zozimoTech/ESP8266_RTOS_SDK/workspace/systemMonitorLab/hardware/Documentos/ESP8266/PinOut.png

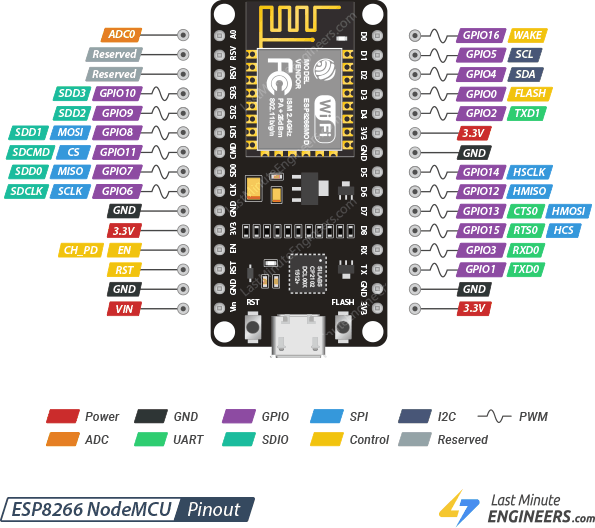
workspace/systemMonitorLab/hardware/Documentos/ESP8266/PinOut.png
