zozimoTech/ESP8266_RTOS_SDK/workspace/systemMonitorLab/hardware/NodoAmbienteSMN/NodoV2/pcb_build_resources/listaComponentesCompra.xlsx

Sheet: listaComponentesCompra
Qty 1 nodo | Qty Total 6 nodos | Value | Proveedor link | Precio unidad | Precio total | Datasheet
6 | 36 | MACHO .100" P/CI 4 VIAS 90* | https://www.sycelectronica.com.ar/articulo.php?codigo=WF4R | 108 | 3888
 | 0 | TERMINAL CRIMPEABLE EN ROLLO | https://www.sycelectronica.com.ar/articulo.php?codigo=HUT | 48 | 0
6 | 36 | HEMBRA A CABLE .1" 4 V | https://www.sycelectronica.com.ar/articulo.php?codigo=HU4 | 60 | 2160
1 | 6 | WF2R MACHO .100" P/CI 2 VIAS 90* | https://www.sycelectronica.com.ar/articulo.php?codigo=WF2R | 66 | 396
1 | 6 | ConectorDCRoscaHembra | https://www.electrocomponentes.com/tienda/componentes-electronicos/conectores/jackdc21rosca?q=JACKDC2.1ROSCA | 2261 | 13566
3 | 18 | BC847B NPN 100MA 50V SMD (SOT-23) | https://www.sycelectronica.com.ar/articulo.php?codigo=BC847B | 60 | 1080
2 | 12 | RESISTOR SMD 1206 100PCS 5K6 | https://www.sycelectronica.com.ar/articulo.php?codigo=CR1206-5K6 | 1104 | 13248
3 | 18 | CR1206-1K RESISTOR SMD 1206 100PCS 1K | https://www.sycelectronica.com.ar/articulo.php?codigo=CR1206-1K | 1104 | 19872
2 | 12 | CR1206-100 RESISTOR SMD 1206 100PCS 100E | https://www.sycelectronica.com.ar/articulo.php?codigo=CR1206-100 | 1104 | 13248
3 | 18 | CR1206-47 RESISTOR SMD 1206 100PCS 47E (En lugar de 39 Ohm) | https://www.sycelectronica.com.ar/articulo.php?codigo=CR1206-47 | 1104 | 19872
3 | 18 | FCG10C CABLE PLANO 10 VIAS COLOR (18 metros) | https://www.sycelectronica.com.ar/articulo.php?codigo=FCG10C |  | 0
 | 0 |  |  |  | 0
 | 0 |  |  |  | 0
 | 0 |  |  |  | 0
 | 0 |  |  |  | 0
 | 0 |  |  |  | 0
 | 0 |  |  |  | 0
 | 0 |  |  |  | 0
 | 0 |  |  |  | 0

Sheet: BOM
Reference | Qty | Value | Footprint | Proveedor link | Precio unidad | Precio total | Datasheet
D1 | 1 | LED_YELLOW | LED_THT:LED_D3.0mm |  |  | 0 | ~
D2 | 1 | LED_Dual_AKA | LED_THT:LED_D3.0mm-3 |  |  | 0 | ~
J1 | 1 | Molex_MainBoard_DHT22 | Connector_PinHeader_2.54mm:PinHeader_1x04_P2.54mm_Horizontal | https://www.sycelectronica.com.ar/articulo.php?codigo=WF4R | 108 | 108 | ~
J2 | 1 | Molex_MainBoard_BMP280 | Connector_PinHeader_2.54mm:PinHeader_1x04_P2.54mm_Horizontal | https://www.sycelectronica.com.ar/articulo.php?codigo=WF4R | 108 | 108 | ~
J3 | 1 | Molex_MainBoard_Led_Status | Connector_PinHeader_2.54mm:PinHeader_1x04_P2.54mm_Horizontal | https://www.sycelectronica.com.ar/articulo.php?codigo=WF4R | 108 | 108 | ~
J4 | 1 | DC 5V | Connector_PinHeader_2.54mm:PinHeader_1x02_P2.54mm_Horizontal |  |  | 0 | ~
J5 | 1 | Molex_Sensor_BMP280 | Connector_PinHeader_2.54mm:PinHeader_1x04_P2.54mm_Horizontal | https://www.sycelectronica.com.ar/articulo.php?codigo=WF4R | 108 | 108 | ~
J6 | 1 | Molex_Sensor_DHT22 | Connector_PinHeader_2.54mm:PinHeader_1x04_P2.54mm_Horizontal | https://www.sycelectronica.com.ar/articulo.php?codigo=WF4R | 108 | 108 | ~
J7 | 1 | Molex_Led_Status | Connector_PinHeader_2.54mm:PinHeader_1x04_P2.54mm_Horizontal | https://www.sycelectronica.com.ar/articulo.php?codigo=WF4R | 108 | 108 | ~
Q1-Q2-Q3 | 3 | NPN | Package_TO_SOT_SMD:SOT-23 |  |  | 0 | https://ngspice.sourceforge.io/docs/ngspice-html-manual/manual.xhtml#cha_BJTs
R1 | 1 | 5K6 | Resistor_SMD:R_1206_3216Metric |  |  | 0 | ~
R2-R4-R7 | 3 | 1k | Resistor_SMD:R_1206_3216Metric |  |  | 0 | ~
R3 | 1 | 100 | Resistor_SMD:R_1206_3216Metric |  |  | 0 | ~
R5-R6 | 2 | 39 | Resistor_SMD:R_1206_3216Metric |  |  | 0 | ~
U1 | 1 | NodeMcuEsp8266 | Module_commercial:ESP8266_v3 |  |  | 0
U2 | 1 | Bmp280Module | Sensors_commercial:BMP280_Module |  |  | 0
U3 | 1 | DHT22 | Sensor:Aosong_DHT11_5.5x12.0_P2.54mm |  |  | 0
