zozimoTech/ESP8266_RTOS_SDK/workspace/systemMonitorLab/hardware/NodoAmbienteSMN/NodoV2/PcbSistemaAmbienteLab_shield_base_2.step

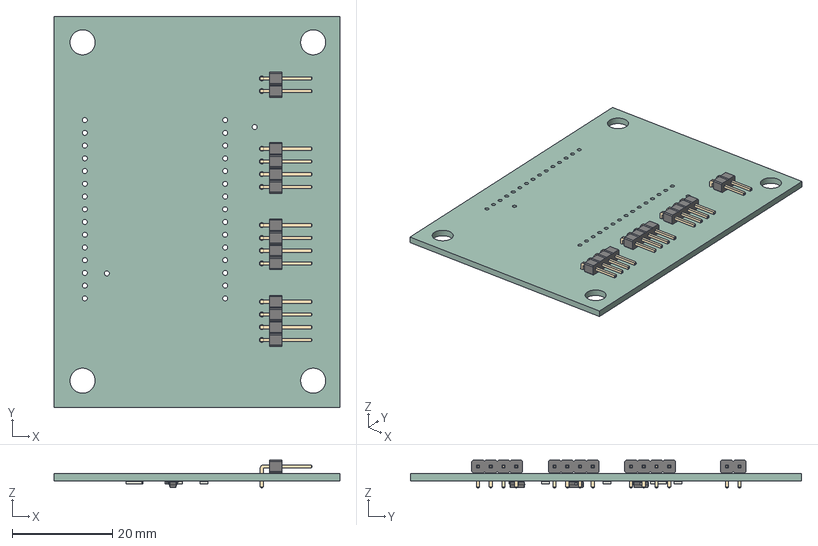
[picture p2: CAD file, 2026-03-22]
workspace/systemMonitorLab/hardware/NodoAmbienteSMN/NodoV2/PcbSistemaAmbienteLab_shield_base_2.step
57.0 x 78.0 x 5.54 mm
PinHeader_1x04_P2.54mm_Horizontal x 3
PinHeader_1x02_P2.54mm_Horizontal
SOT-23 x 3
R_1206_3216Metric x 7
PcbSistemaAmbienteLab_shield_base_2_PCB
