zozimoTech/ESP8266_RTOS_SDK/workspace/systemMonitorLab/hardware/NodoAmbienteSMN/NodoV2/negativos/PcbSistemaAmbienteLab_shield_Leds-B_Cu.pdf

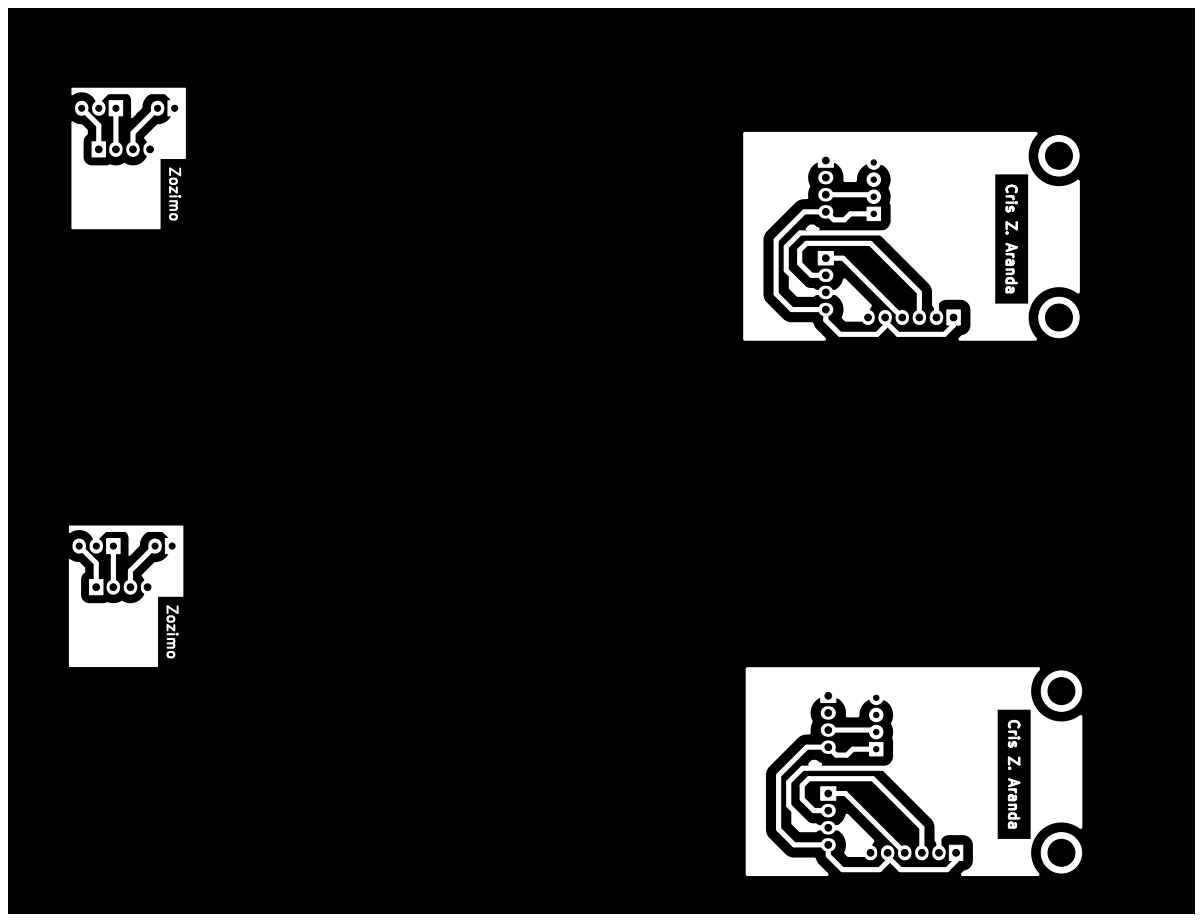
[picture p4: page 1]

Zozimo Cris Z. Aranda Cris Z. Aranda Zozimo
