zozimoTech/ESP8266_RTOS_SDK/workspace/systemMonitorLab/hardware/NodoAmbienteSMN/NodoV2/negativos/PcbSistemaAmbienteLab_shield_Leds-F_Mask.pdf

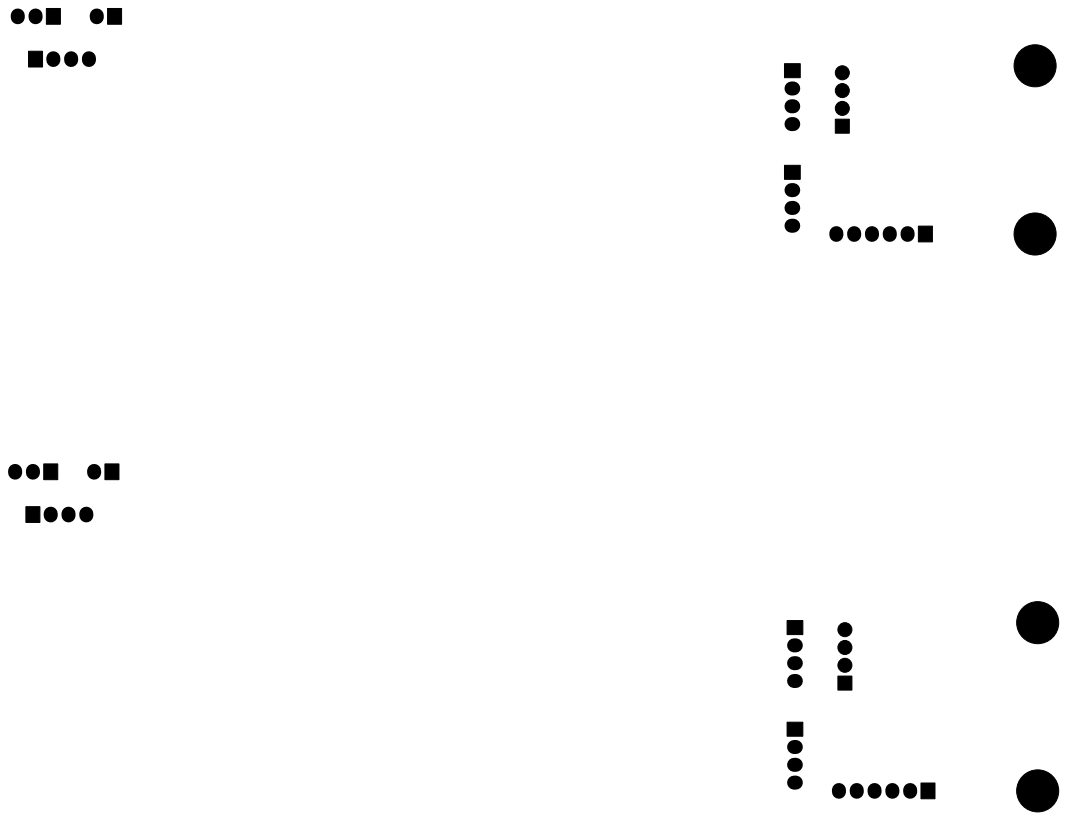
[picture p5: page 1]
