zozimoTech/ESP8266_RTOS_SDK/workspace/systemMonitorLab/hardware/NodoAmbienteSMN/NodoV2/negativos/PcbSistemaAmbienteLab_shield_base_2-B_Cu.pdf

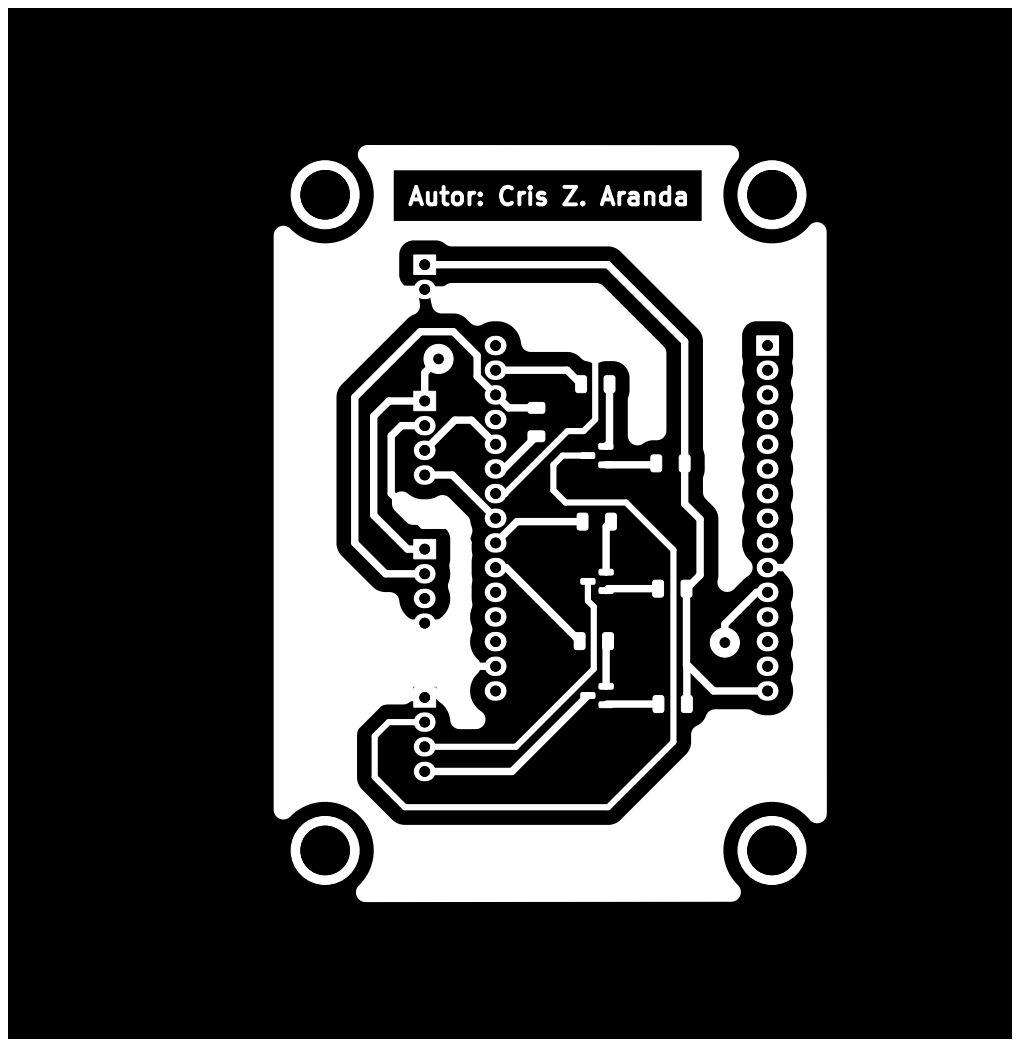
[picture p6: page 1]
