zozimoTech/ESP8266_RTOS_SDK/workspace/systemMonitorLab/hardware/NodoAmbienteSMN/NodoV2/pcb_build_resources/PCB_shield_main_board.pdf

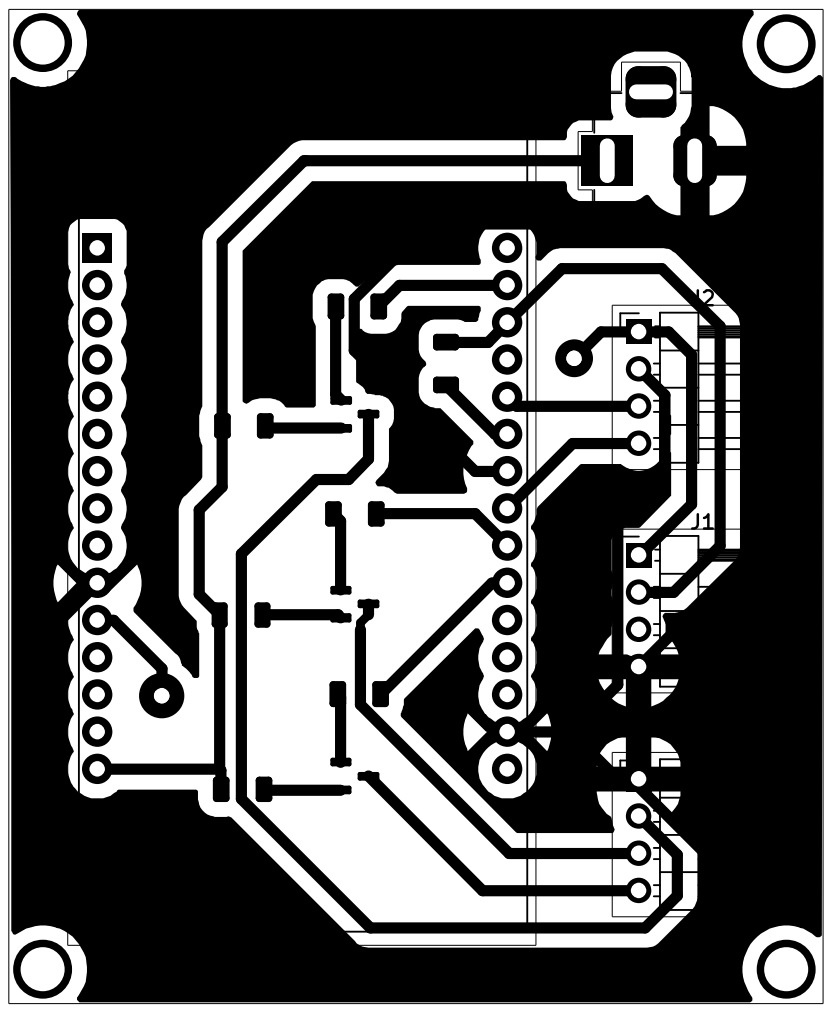
[picture p7: page 1]
