zozimoTech/ESP8266_RTOS_SDK/workspace/systemMonitorLab/hardware/NodoAmbienteSMN/NodoV2/pcb_build_resources/PCB_shield_main_board_mirror.pdf

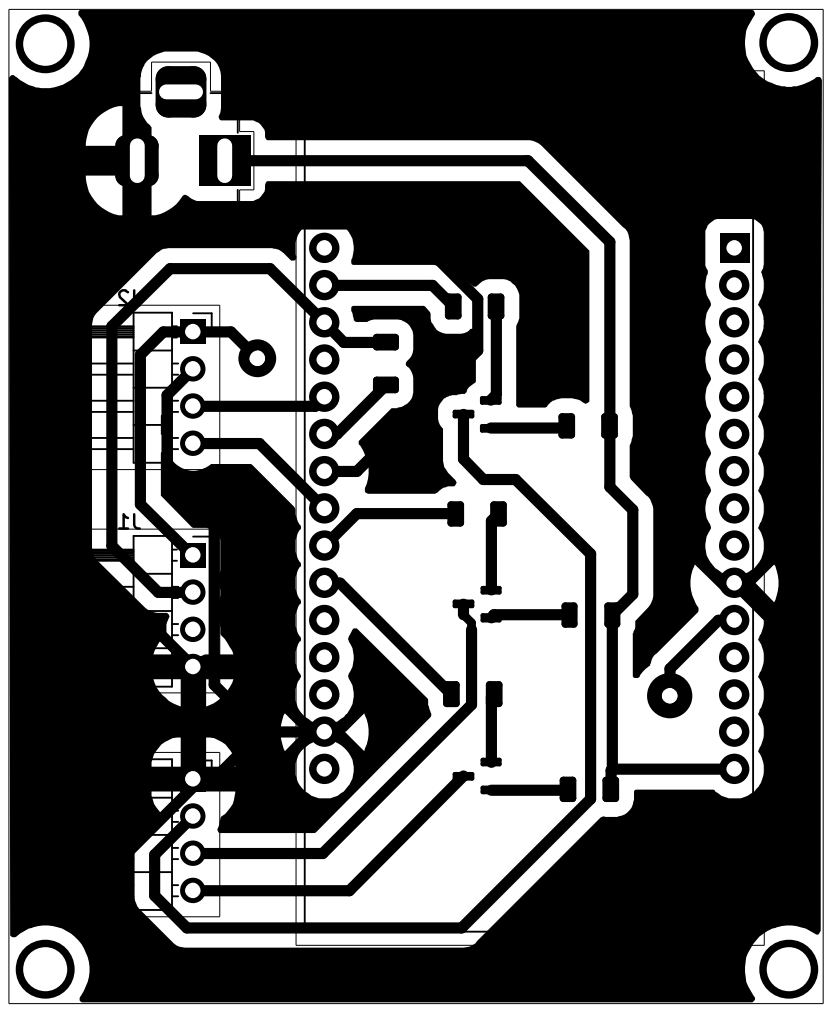
[picture p8: page 1]
