zozimoTech/ESP8266_RTOS_SDK/workspace/systemMonitorLab/hardware/NodoAmbienteSMN/recursos/simulaciones/control_LED_3_3_to_5.asc

D1: LED
Q1: npn
R1: res; 39
R2: res; 1k
V1: voltage; 5v
V2: voltage; PULSE(0 3.3 0 0 0 250u 1m 10)
Named nets: 0
.tran 0 100ms 0 500u
