zozimoTech/ESP8266_RTOS_SDK/workspace/systemMonitorLab/hardware/NodoAmbienteSMN/recursos/simulaciones/convertidor3_3_to_5.asc

Q1: npn
R1: res; 10k
R2: res; 4.7k
R3: res; 10k
R4: res; 1Meg
V1: voltage; 3.3
V2: voltage; 5
V3: voltage; PULSE(0 3.3 0 0 0 500u 1m 100)
Named nets: 0, vpwm, pwm5v
.tran 0 50m 0 1ms
