zozimoTech/ESP8266_RTOS_SDK/workspace/systemMonitorLab/hardware/NodoAmbienteSMN/NodoV2/PcbSistemaAmbienteLab.kicad_pcb

## KiCad design workspace/systemMonitorLab/hardware/NodoAmbienteSMN/NodoV2/PcbSistemaAmbienteLab.kicad_pcb (2025-08-23)

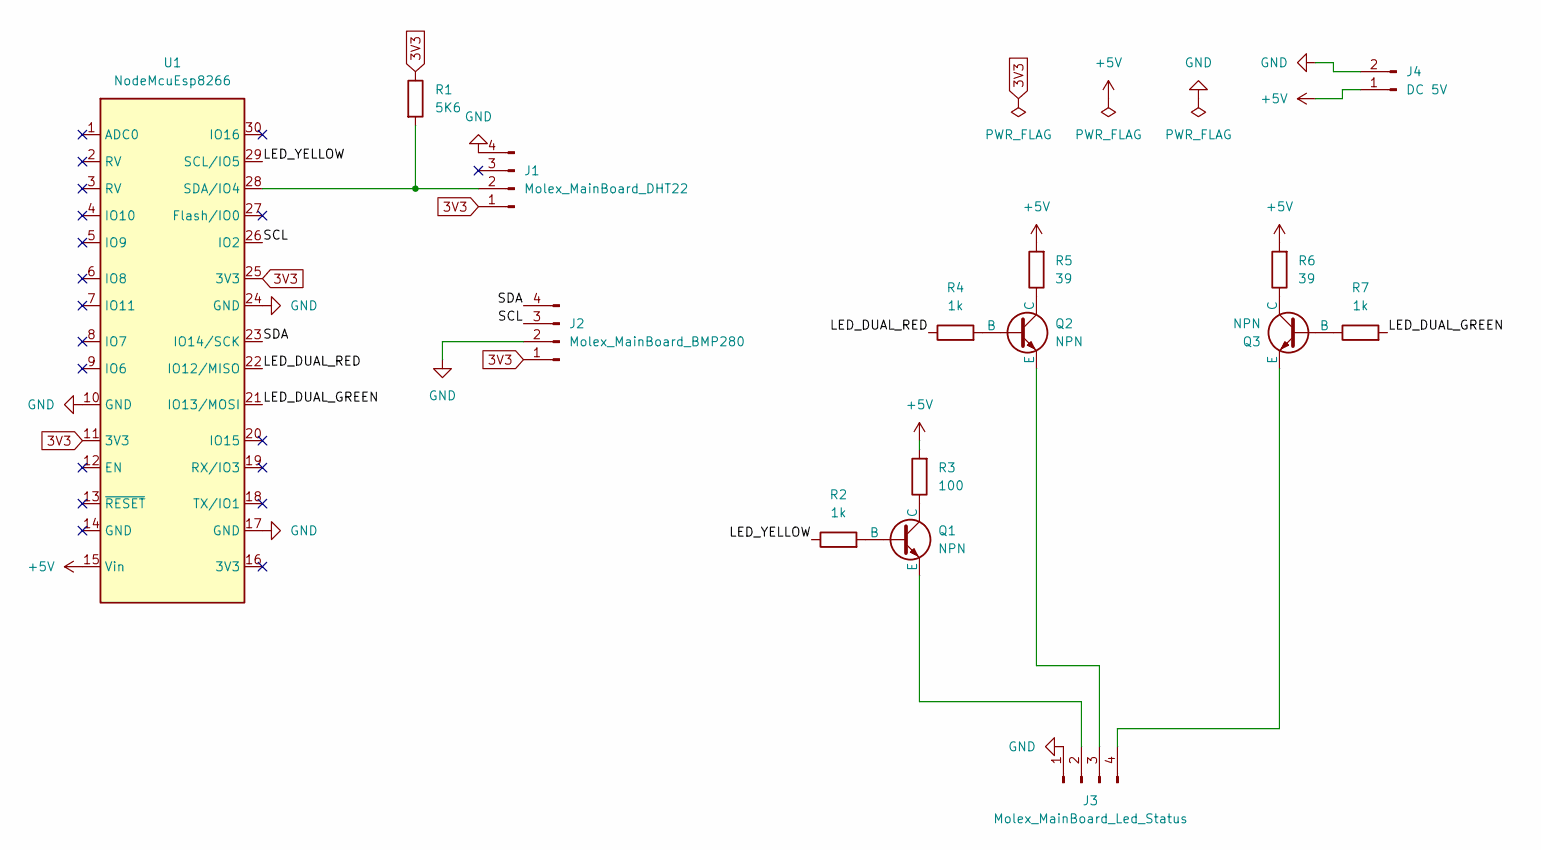
[picture p9: schematic shield_base.kicad_sch, shield_base_nodo_lab_smn]

Parts:
J1: Molex_MainBoard_DHT22; PinHeader_1x04_P2.54mm_Horizontal
J2: Molex_MainBoard_BMP280; PinHeader_1x04_P2.54mm_Horizontal
J3: Molex_MainBoard_Led_Status; PinHeader_1x04_P2.54mm_Horizontal
J4: DC 5V; PinHeader_1x02_P2.54mm_Horizontal
Q1, Q2, Q3: NPN; SOT-23
R1: 5K6; R_1206_3216Metric
R2, R4, R7: 1k; R_1206_3216Metric
R3: 100; R_1206_3216Metric
R5, R6: 39; R_1206_3216Metric
U1: NodeMcuEsp8266; ESP8266_v3

Connections:
3V3: J1.1, J2.1, R1.1, U1.11 (3V3), U1.25 (3V3); also elsewhere on the board
+5V: J4.1, R3.2, R5.2, R6.2, U1.15 (Vin)
/shield_base/LED_DUAL_GREEN: R7.2, U1.21 (IO13/MOSI)
/shield_base/LED_DUAL_RED: R4.1, U1.22 (IO12/MISO)
/shield_base/LED_YELLOW: R2.1, U1.29 (SCL/IO5)
/shield_base/SCL: J2.3, U1.26 (IO2)
/shield_base/SDA: J2.4, U1.23 (IO14/SCK)
GND: J1.4, J2.2, J3.1, J4.2, U1.10 (GND), U1.17 (GND), U1.24 (GND); also elsewhere on the board
unnamed: J1.2, R1.2, U1.28 (SDA/IO4)
unnamed: J3.2, Q1.3 (E)
unnamed: J3.3, Q2.3 (E)
unnamed: J3.4, Q3.3 (E)
unnamed: Q1.2 (B), R2.2
unnamed: Q1.1 (C), R3.1
unnamed: Q2.2 (B), R4.2
unnamed: Q2.1 (C), R5.1
unnamed: Q3.2 (B), R7.1
unnamed: Q3.1 (C), R6.1

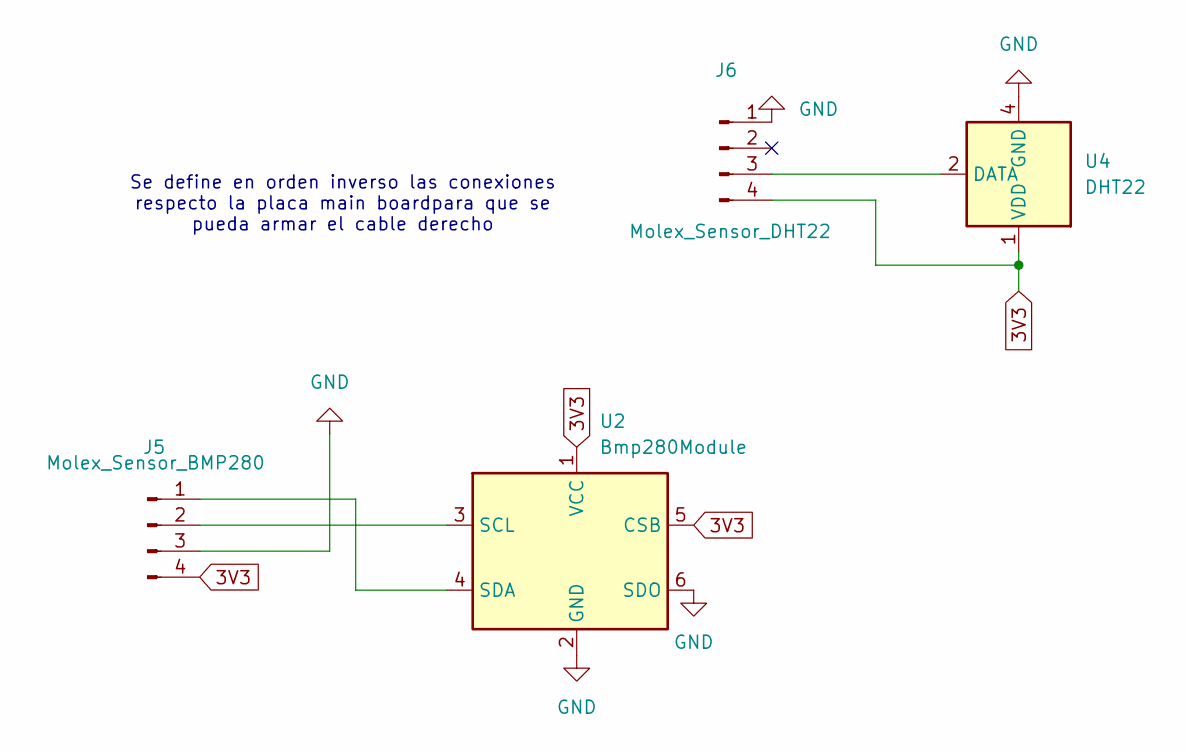
[picture p10: schematic shield_sensor.kicad_sch, shield_sensors_nodo]

Parts:
J5: Molex_Sensor_BMP280; PinHeader_1x04_P2.54mm_Horizontal
J6: Molex_Sensor_DHT22; PinHeader_1x04_P2.54mm_Horizontal
U2: Bmp280Module; BMP280_Module
U4: DHT22; Aosong_DHT11_5.5x12.0_P2.54mm

Connections:
3V3: J5.4, J6.4, U2.1 (VCC), U2.5 (CSB), U4.1 (VDD); also elsewhere on the board
GND: J5.3, J6.1, U2.2 (GND), U2.6 (SDO), U4.4 (GND); also elsewhere on the board
unnamed: J5.1, U2.4 (SDA)
unnamed: J5.2, U2.3 (SCL)
unnamed: J6.3, U4.2 (DATA)

Notes on the sheet:
Se define en orden inverso las conexiones respecto la placa main boardpara que se pueda armar el cable derecho

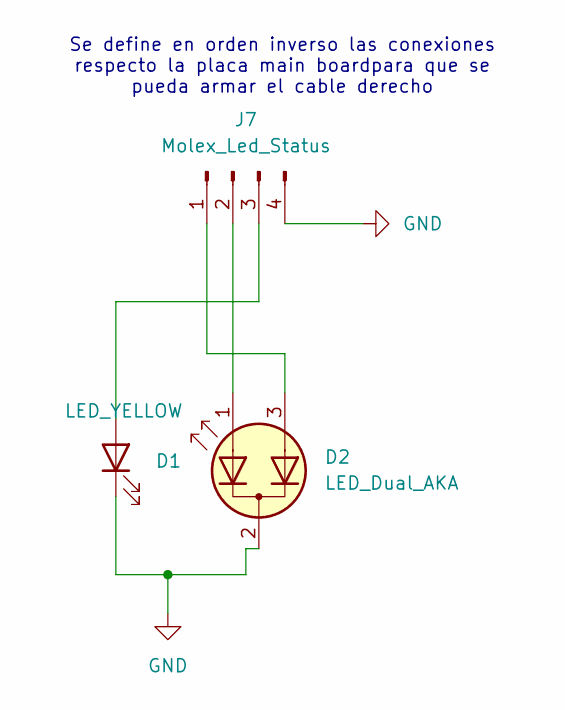
[picture p11: schematic shield_leds_status.kicad_sch, shield_leds_status_nodo]

Parts:
D1: LED_YELLOW; LED_D3.0mm
D2: LED_Dual_AKA; LED_D3.0mm-3
J7: Molex_Led_Status; PinHeader_1x04_P2.54mm_Horizontal

Connections:
GND: D1.1 (K), D2.2 (K), J7.4; also elsewhere on the board
unnamed: D1.2 (A), J7.3
unnamed: D2.1 (A1), J7.2
unnamed: D2.3 (A2), J7.1

Notes on the sheet:
Se define en orden inverso las conexiones respecto la placa main boardpara que se pueda armar el cable derecho

Board: 2 copper layers, 22 parts (0 on the bottom side), 24 nets, no tracks yet.
