zozimoTech/ESP8266_RTOS_SDK/workspace/test_examples/pwm/main/pwm_example_main.c

/* pwm example

   This example code is in the Public Domain (or CC0 licensed, at your option.)

   Unless required by applicable law or agreed to in writing, this
   software is distributed on an "AS IS" BASIS, WITHOUT WARRANTIES OR
   CONDITIONS OF ANY KIND, either express or implied.
*/

#include <stdio.h>
#include <string.h>
#include <stdlib.h>

#include "freertos/FreeRTOS.h"
#include "freertos/task.h"
#include "freertos/queue.h"

#include "esp_log.h"
#include "esp_system.h"
#include "esp_err.h"

#include "esp8266/gpio_register.h"
#include "esp8266/pin_mux_register.h"

#include "driver/pwm.h"


#define PWM_0_OUT_IO_NUM   5  //Led amarillo
#define PWM_1_OUT_IO_NUM   12 //Led rojo
#define PWM_2_OUT_IO_NUM   13 //Led verde


// PWM period 1000us(1Khz), same as depth
#define PWM_PERIOD    (1000)

static const char *TAG = "pwm_example";

// pwm pin number
const uint32_t pin_num[3] = {
    PWM_0_OUT_IO_NUM,
    PWM_1_OUT_IO_NUM,
    PWM_2_OUT_IO_NUM,
};

// duties table, real_duty = duties[x]/PERIOD
uint32_t duties[3] = {
    1000, 1000, 600
};

// phase table, delay = (phase[x]/360)*PERIOD
float phase[3] = {
    0, 0, 90.0
};

void app_main()
{
    pwm_init(PWM_PERIOD, duties, 3, pin_num);
    pwm_set_phases(phase);
    pwm_start();
    int16_t count = 0;

    while (1) {

        // if (count == 20) {
        //     // channel0, 1 output hight level.
        //     // channel2, 3 output low level.
        //     pwm_stop(0x0);
        //     ESP_LOGI(TAG, "PWM stop\n");
        // } else if (count == 30) {
        //     pwm_start();
        //     ESP_LOGI(TAG, "PWM re-start\n");
        //     count = 0;
        // }

        // count++;
        duties[2] = duties[2] + 100;
        if (duties[2] >= 1000) {
            duties[2] = 0;
        }
        ESP_LOGI(TAG, "Duty cycle: %u\n", duties[2]);
        pwm_set_duties(duties);
        pwm_start();
        vTaskDelay(5000 / portTICK_RATE_MS);
    }
}
