zozimoTech/ESP8266_RTOS_SDK/(commit log)

2025-02-26 Se termino de generar el diseño de la placa shield_main_board.
    [PcbSistemaAmbienteLab.kicad_sch, PcbSistemaAmbienteLab_shield_base_2.kicad_pcb, PcbSistemaAmbienteLab_shield_sensors.kicad_pcb, shield_base.kicad_sch, shield_leds_status.kicad_sch, shield_sensor.kicad_sch]
2025-02-26 Subo modificaciones en el PCB shield_sensors
    [PcbSistemaAmbienteLab_shield_base_2.kicad_pcb, PcbSistemaAmbienteLab_shield_sensors.kicad_pcb]
2025-02-27 Borro un archivo de backup que no permite descargar el repo
2025-02-27 Actulizamos pcbs de nodo ambiente v2
    [PcbSistemaAmbienteLab_shield_base_2.kicad_pcb, PcbSistemaAmbienteLab_shield_sensors.kicad_pcb, shield_base.kicad_sch]
2025-02-27 Agregamos el pcb de los Leds, el siguiente paso es ver los conectores Molex comerciales y ajustar el PCB en base a esa dimensiones
    [PcbSistemaAmbienteLab_shield_Leds.kicad_pcb, PcbSistemaAmbienteLab_shield_base_2.kicad_pcb, PcbSistemaAmbienteLab_shield_sensors.kicad_pcb]
2025-03-02 Se va a cambiar el jack del PCB por un molex 2x1
2025-03-10 Vamos agregando la lista proveedores a la lista de componentes
    [PcbSistemaAmbienteLab_shield_base_2.kicad_pcb, listaComponentesCompra.xlsx, shield_base.kicad_sch]
2025-03-28 Se termino de diseñar la version 2 del nodo ambiente, ahora se va a diseñar el case3d para que contenga al mismo
    [PcbSistemaAmbienteLab_shield_base_2.kicad_pcb, PcbSistemaAmbienteLab_shield_sensors.kicad_pcb, listaComponentesCompra.xlsx]
2025-04-15 Subo el resideño de los pcb's acorde al case 3d
    [PcbSistemaAmbienteLab_shield_Leds.kicad_pcb, PcbSistemaAmbienteLab_shield_base_2.kicad_pcb, PcbSistemaAmbienteLab_shield_sensors.kicad_pcb]
2025-04-25 Cambiamos de IP del servidor WebSocket, ya que desde ahora la app web esta instalada en la raspberry pi con IP 10.10.13.138, entonces se modifico en transmision.c y en la configuracion de la aplicaci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
2025-05-10 Tareas Realizadas: - Se corrije la disposicion de los conectores, para que el cable quede derecho en su construccion se tiene que invertir el orden de los pines en las placas led_status y sensors. - 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
    [PcbSistemaAmbienteLab_shield_Leds.kicad_pcb, PcbSistemaAmbienteLab_shield_base_2.kicad_pcb, PcbSistemaAmbienteLab_shield_sensors.kicad_pcb, shield_leds_status.kicad_sch, shield_sensor.kicad_sch]
2025-06-13 Agrego los negativos para su impresion
    [PcbSistemaAmbienteLab_shield_base_2.kicad_pcb]
2025-06-17 Se actualiza el pcb de sensores
2025-06-17 Se agrega un entorno virtual de python para compilar y fhashear los ESP8266
2025-07-02 probar el main con un esp32
2025-08-23 Se mejora el plano de masa del PCB
    [PcbSistemaAmbienteLab.kicad_pcb, PcbSistemaAmbienteLab_shield_Leds.kicad_pcb, PcbSistemaAmbienteLab_shield_base_2.kicad_pcb, PcbSistemaAmbienteLab_shield_sensors.kicad_pcb, shield_base.kicad_sch, shield_sensor.kicad_sch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]
2026-03-22 Actualizamos el case y el pcb
    [PcbSistemaAmbienteLab_shield_base_2.kicad_pcb, PcbSistemaAmbienteLab_shield_base_2.step]
2026-03-22 Agregamos el nombre del entorno virtual, ademas solo funciona con python 3.10 o menor.
2026-03-30 Se actualiza el README del proyecto systemMonitorLab
2026-08-08 Se sube la version 2.0.1 del firmware del NODO, en particular esta seteado en numero de NODO 0, esto deberia ser modificable por el usuario o salir con un numero de serie unico que reconozca el softw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
2026-09-01 Se esta mejorando el comportamiento de los Leds, acorde a lo siguiente:
    LED DUAL:
    - ROJO ON si esta desconectado de Wifi y por lo tanto del servidor.
    - ROJO ON, VERDE ON (Naranja Marron), Esta conectado a WiFi pero no al servidor Websocket.
    - VERDE ON si esta conectado al Wifi y al servidor, listo para transmitir.
    Led Amarillo: Blinkea cada vez que se enviar un dato al servidor.
2026-09-11 Se modifico la ecuacion que calcula en tiempo para enviar la proxima muestra de mediciones ambiente, de forma tal que si siempre comience enviando en el minuto 00 y el segudo 00.
2026-09-12 - Firmware v1.3 - Hardware v2.0 - Case3d v1.2
    - Proyecto: Sistema de monitoreo de laboratorios
    - Nodo ambiente
    - Autor: Ing. Cristian Aranda.
    Tareas realizadas:
    - Se agregó el parámetro CONFIG_APP_NUMBER_OF_NODE en main/Kconfig.projbuild para configurar desde menuconfig el número identificador del nodo.
    - Se eliminó la macro NUMERO_DE_NODO de main/common.h.
    - Se reemplazaron los usos de NUMERO_DE_NODO en transmission.c por CONFIG_APP_NUMBER_OF_NODE.
    - Se modificaron los mensajes WebSocket para incluir el número de nodo configurado desde menuconfig.
    - Se agregó el parámetro CONFIG_APP_SAMPLE_RATE_SENSORS en main/Kconfig.projbuild.
    - Se reemplazó la macro SAMPLE_RATE_SENSORS de commo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
2026-09-13 Se agrego close(connectionData.socketNumber);, que es el cierre de conexión en caso de fallar en envio de datos o keep alive.
